ymnikaktys/cold-atmospheric-plasma-jet/README.md

# Autonomous Cold Atmospheric Plasma Jet (CAPJ)

High-voltage, nanosecond-pulsed dielectric barrier discharge (DBD) cold plasma torch with an autonomous 2S LiPo power supply, closed-loop resonant ZVS stage, and real-time microcontroller sequencing.

Designed for cold atmospheric plasma research in argon/nitrogen flows: delivers ultra-fast high-voltage streamer breakdown without thermal arc transition ($T_g \approx 300\text{--}315\text{ K}$, touch-safe plume).

---

## System Architecture

* **Primary Resonant Stage (ZVS Push-Pull):** Current-fed push-pull inverter (~98 kHz) using TI CSD18534Q5A NexFETs ($60\text{ V}$, $3.5\text{ m}\Omega$), Bourns SRP1265A $22\ \mu\text{H}$ feed choke, and CBB22 $0.22\ \mu\text{F}$ 630V resonant tank. Steps up $7.4\text{ V}$ battery power to $850\text{ V}$ via an EFD20 (N87/PC40) transformer.
* **Gate Drive & Zero-Crossing Sync:** Dual high-speed low-side driver TI UCC27524DR ($5\text{ A}$ peak). Real-time zero-crossing detection on MOSFET drains feeds directly into STM32 internal analog comparators (COMP1/COMP2) with BAT54C rail clamps to maintain soft-switching under varying loads.
* **HV DC Bus & Isolation:** $850\text{ V}$ buffer ($2\times \text{CBB81 } 1\text{ nF } 2000\text{V}$) with a $19.5\text{ M}\Omega$ thick-film bleeder array. Voltage feedback is fully isolated through a TI AMC1311 differential amplifier ($5\text{ kV}$ galvanic barrier) powered by a Mornsun B0505S-1WR3 ($3\text{ kV}$ DC-DC) and ME6211 LDO.
* **Nanosecond Pulsing Discharge:** Cree/Wolfspeed C3M0075120K SiC MOSFET ($1200\text{ V}$, $30\text{ A}$, TO-247-4) driven by a UCC27511DBVR at $+15\text{ V}$ (via MT3608 booster). True 4-pin Kelvin Source topology eliminates gate-loop ground bounce. Discharges the bus into an Epcos N87 ferrite toroid T2 (desoldering braid primary, UL3239 HV secondary) to hit $>7\text{ kV}_{p-p}$ at sub-15 ns rise times.
* **Clamping & Snubbing:** High-voltage SiC Schottky diode Cree C4D02120E ($1200\text{ V}$, zero reverse recovery) in an RCD clamp plus a primary RC snubber to eliminate destructive drain overshoots during nanosecond shut-off.
* **Fluidics & Gas Block:** Integrated 0520D 6V micro-solenoid for gas cut-off, tangential swirl chamber (swirl injection) with direct PC4-M5 pneumatic coupling, fused quartz tube ($\varnothing 6.0/\varnothing 4.0\text{ мм}$), and an axially centered WL-20 lanthanated tungsten needle.
* **Control Core:** WeAct Studio STM32G474CEU6 ($170\text{ MHz}$ Cortex-M4F, HRTIM with $184\text{ ps}$ resolution, ultra-fast comparators for sub-$25\text{ ns}$ OVP shutdown), 0.96″ SPI OLED, and EC11 digital encoder for gas profile/pulse repetition rate control.
* **Power & Protection:** 2S LiPo ($7.4\text{ V}$, $1100\text{ mAh}$, $140\text{C}$ burst), high-side soft-switch via AOD4185 P-MOSFET, AMFM 20A blade fuse in Keystone 3544 PCB clips, and synchronous MP2315 buck converter for clean $+3.3\text{ V}$ system rail.

---

## Physics & Simulation Targets

* **Output Voltage:** $V_{p-p} \approx 7.0\text{--}7.7\text{ kV}$
* **Slew Rate ($dV/dt$):** $>10\text{ kV/ns}$ (QSpice transient model yields up to $13\text{ kV/ns}$)
* **Pulse Duration:** $50\text{--}150\text{ ns}$
* **Discharge Mode:** Self-terminating Dielectric Barrier Discharge (DBD)
* **Gas Flow:** Industrial Argon / Nitrogen at $1.0\text{--}1.5\text{ bar}$ regulated line pressure

---

## Repository Layout

```text
├── docs/                 # System technical specifications, BOM sheets, and schematics PDF
├── firmware/             # STM32CubeIDE real-time C/C++ state machine (Preflow -> Charge -> Fire -> Postflow)
├── Hardware/             # Altium Designer 4-layer PCB design (CPJ.PcbDoc, hierarchical SchDocs, OutJob)
├── Libraries/            # Custom component libraries (symbols *.SchLib and footprints *.PcbLib)
├── mechanic/             # Enclosure CAD source and production assets
│   ├── 3d_print/         # Sliced/production STEP files (L/R shells, swirl nozzle block, trigger)
│   ├── components_step/  # Reference STEP models for grabcad/board components
│   └── Plasma_Pistol_Assembly.plasticity
├── outputs/              # Production Gerbers, NC drill, stackup info, and pick-and-place files
└── sim/                  # QSpice transient analysis circuits (*.qsch) and raw simulation captures

```
## Safety & Operating Notes

> [!CAUTION]
> ### DANGER: HIGH-VOLTAGE NANOSECOND PULSE GENERATOR
>
> * **Lethal Transients ($7.7\text{ kV}_{p-p}$):** Output pulse slew rate exceeds $10\text{ kV/ns}$. Never operate the board outside its grounded enclosure or without a differential HV probe ($100:1\ /\ 2\text{ kV}$ rating minimum).
>
> * **Stored Capacitive Energy ($850\text{ V}$):** The intermediate bus is buffered by polypropylene film capacitors. Wait at least **5 seconds** after cutting primary power for the bleeder resistor array ($19.5\text{ M}\Omega$) to safely drain the bus below $50\text{ V}$ before touching the board.
>
> * **Dielectric Protection:** Ensure continuous argon pre-flow prior to firing. Firing without gas flow will cause thermal air arc transition and permanent quartz tube erosion.
