ymnikaktys/cold-atmospheric-plasma-jet/docs/BOM.md

# Спецификация компонентов Cold Atmospheric Plasma Jet (Rev. 1.2)

> **Статус распределения:**
> * `[x]` — На руках куплено.
> * `(корзина VP)` — В корзине магазина.
> * `(корзина Алик)` — чипы, модули, силовые элементы и ленты с AliExpress
> * `(не закинуто)` — узлы второй очереди (моточная оснастка, сопло, пневматика, аккумулятор, корпус).

---

### Мозги (Управление и контроль) (УГО[x])

- [x] **Микроконтроллер:** WeAct Studio STM32G474CEU6
- [x] **Программатор:** WeAct Studio Mini STLink-STM32 v2.1
- [ ] **Защита ПК:** USB-изолятор на ADuM3160 — `(не закинуто)`
- [ ] **Высоковольтный щуп:** FNIRSI P4100 (100MHz, 100:1, 2 kV) — `(не закинуто)`
- [x] **Дисплей:** OLED 0.96″ 128×64, SSD1306, **SPI 7 pin**, белый
- [x] **Последовательные демпферы линий SPI:** Резисторы 33 Ом 1% SMD 0603 (40 шт.)
- [x] **ВЧ блокировочный конденсатор дисплея:** 100nF 50V X7R SMD 0603 (30 шт.)
- [x] **Локальный накопитель повышайки матрицы:** 10uF 16V X7R SMD 0805 (10 шт.)

---

### Ввод питания, защита и низковольтная логика (УГО[x])

1) Главный электронный рубильник питания (Q_PWR, SW_PWR):
    - [x] **Силовой P-Ch MOSFET рубильника (Q_PWR):** AOD4185 (TO-252)
    - [x] **Главный ползунковый микротумблер (SW_PWR):** SS-12D00G6 шток 6 мм
    *(Коммутирует только затвор мосфета на землю микротоком 0.08 мА).*
    - [x] **Подтяжка затвора ключа питания (100k):** Резистор 100k 1% SMD 0603 (40 шт.)

2) Защита от короткого замыкания (F1):
    - [x] **Предохранитель силовой шины (F1):** Ножевой AMFM-20A (2 шт.)

3) Входной сглаживающий фильтр (C3, C4 перед дросселем L6):
    - [x] **Держатели предохранителя на плату:** Клипсы Keystone 3544 под пайку (10 шт.)
    - [x] **Входной полимерный накопитель (перед L6):** 100uF 16V SMD 6.3×5.7 мм Hitano EZV
    *(Компенсирует паразитную индуктивность проводов батареи при импульсах).*
    - [x] **Входная ВЧ керамика фильтра:** 22uF 25V X7R SMD 1210 (10 шт.)
     *(3 х 22uf. Гасят реактивный ВЧ-ток 350 кГц с околонулевым ESR).*

4) Мониторинг напряжения аккумулятора (делитель на АЦП STM32):
    - [x] **Делитель мониторинга АКБ (верхнее плечо):** Резистор 100k 0603
    - [x] **Делитель мониторинга АКБ (нижнее плечо):** Резистор 47.5k 1% SMD 0603 (10 шт.)
    - [x] **Фильтр шумов АЦП батареи:** Конденсатор 100nF 0603
    *(Делит максимальные 8.4V батареи в безопасные 2.68V для прямого замера АЦП контроллера).*

5) Кнопка курка (BTN_TRIG):
    - [x] **Кнопка курка:** Тактовая кнопка BS-110-NL-Black

6) Инкрементальный энкодер навигации и выбора профилей газа (ENC1):
    - [x] **Инкрементальный энкодер (ENC1):** EC11 с кнопкой (вал с резьбой) `
    - [x] **Ручка энкодера:** Металлическая ручка под вал 6 мм

---

### Низковольтная часть (Силовой ZVS-контур):

1) Силовой ввод и аккумулятор:
    - [x] **Аккумулятор:** Акумулятор GNB 2S 720mAh 100C/200C HV XT30 8.7V
    - [x] **Силовой разъем на плату:** Amass XT30PW-M (угловой штыревой в плату)

2) Силовые ключи:
    - [x] **Силовые ключи ZVS (M1, M2):** CSD18534Q5A (DFN 5×6, 60V, 3.5 мОм, 5 шт.)

3) Готовый DC-DC преобразователь 3.3V (питание STM32, экрана и логики):
    - [x] **DC-DC логики +3.3V:** Синхронный понижающий модуль MP2315 (Mini-3A)

4) Драйвер и обвязка его:
    - [x] **Драйвер затворов ZVS:** Двухканальный UCC27524DR (SOIC-8, 5A)
    - [x] **ВЧ блокировка питания драйвера UCC27524:** 100nF 50V X7R 0603
    - [x] **Накопитель питания драйвера UCC27524:** 2.2uF 25V X7R SMD 0805 (10 шт.)
    *(Ставятся параллельно впритык к ножкам VDD (pin 6) и GND (pin 3) драйвера)*

5) Защита затворов (Снабберы и супрессоры):
    - [x] **Супрессоры защиты стоков (TVS 1-2):** 1.5SMC39A (SMC / DO-214AB, 20 шт.)
    - [x] **Снабберные резисторы стоков (R7, R8):** 5.62 Ом 1% SMD 1206 (25 шт.) —
    - [x] **Снабберные емкости стоков (C7, C8):** 2.2nF 100V NP0 SMD 1206 (20 шт.)

6) Входной накопительный дроссель пуш-пула (L6):
    - [x] **Входной дроссель питания ZVS:** Силовой SMD SRP-1265A 22uH (12×12×7 мм, 1 шт.)

7) Первичный резонансный конденсатор (C1):
    - [x] **Резонансный конденсатор первички (C1):** CBB22 0.22uF 630V P=15mm (10 шт.)

8) Трансформатор накачки шины 850V (T1):
    - [x] **Ферритовый сердечник T1:** EFD20 (каркас 8-pin + феррит N87 / PC40) —
    - [x] **Провод первички T1:** ПЭТВ-2 0.75 мм (1 м)
    - [x] **Провод вторички T1:** Тройная изоляция TIW-B 0.18–0.20 мм
    - [x] **Межобмоточная изоляция T1:** Каптоновый скотч 10 мм

---

### Детектор перехода через ноль (Zero-Crossing) и затворы ZVS (УГО[x])

1) Делители с дрейнов мосфетов (Drain Zero-Cross  на встроенные компараторы STM32):
    - [x] **Делители стоков ZVS (верхние плечи):** Резисторы 10k 0603
    - [x] **Делители стоков ZVS (нижние плечи):** Резисторы 1k 5% SMD 0603 (100 шт.)
    *(Делят выброс стока 35V до безопасных 3.18V прямо на пины COMP1_INP / COMP2_INP микроконтроллера)*
    - [x] **Защита входов компараторов STM32:** Диодная сборка BAT54C SOT-23 (30 шт.)
    *(Срезают любые импульсы выше 3.6V, гарантируя защиту пинов STM32)*

2) Обратные диоды быстрого закрытия (D14 и второй в паре):
    - [x] **Диоды быстрого разряда затворов:** Шоттки 1N5819HW SOD-123 (5 шт.)

3) Защитные стабилитроны затворов (D5, D6):
    - [x] **Защитные стабилитроны затворов:** BZX84-C15 SOT-23 (10 шт.)

3) Стягивающие резисторы затворов (R5, R6):
    - [x] **Стягивающие резисторы:** 10k 1% SMD 0603 (25 шт.)

4) Затворные резисторы включения (R3 и второй в паре):
    - [x] **Токоограничивающие резисторы затворов:** 4.7 Ом 0603 (40 шт.)

---

### Высоковольтный измеритель шины 850V (AMC1311) (УГО[x])
1) Изолированный усилитель напряжения:
    - [x] **Изолированный усилитель:** AMC1311BQDWVRQ1 (SOIC-8 Wide Body)

2) Высоковольтный делитель верхнего плеча (850V -> 1.7V):
    - [x] **Высоковольтный делитель верхнего плеча (850V):** Резисторы 510k 1% SMD 1210
    *4 штуки последовательно*
3) Нижнее плечо делителя и ВЧ фильтр:
    - [x] **Нижнее плечо делителя шины:** Резистор 3.9k 5% SMD 0603 (200 шт.)
    - [x] **ВЧ фильтр входа AMC1311:** Конденсатор 1nF 50V NP0 SMD 0603 (30 шт.)

4) Обвязка питания горячей стороны:

    - [x] **Гальваническая развязка питания 5V (3 кВ):** Mornsun B0505S-1WR3 (SIP-4)
    - [x] **LDO горячей стороны AMC1311:** ME6211C50M5G (5.0V, SOT-23-5, 5 шт.)
    *(Сбрасывает 7.4V с батареи до чистых 5.0V без просадок при старте)*
    - [x] **Входная емкость LDO ME6211:** Конденсатор 4.7uF 16V X7R SMD 0805 (10 шт.)
    *Фильтрующая керамика на вход ME6211*
    - [x] **Догрузочный резистор B0505S:** Резистор 300 Ом 1% SMD 0805 (100 шт.)
    *(Дает стабильный ток 15 мА, удерживая выход B0505S ровно на 5.0V без бросков до 7V)*
    - [x] **Локальный блокировочный конденсатор AMC1311:** 100nF 50V X7R 0603
    *(Ставится в упор к выводам VDD1 и GND1 микросхемы AMC1311)*

---

### Высоковольтный наносекундный разрядник сопла (850V -> 7.7 kVpp) (УГО[x])
1) Выпрямитель вторички транса T1:
    - [x] **Мостовой выпрямитель T1:** Ультрабыстрые диоды US2M (1000V, 2A, 75ns, SMA)
    *2 шт. последовательно на каждое плечо*

2) Буферный HV накопитель (C_BUF) — запас 2000V:
    - [x] **Буферный накопитель шины (C_BUF):** Полипропилен CBB81 1nF 2000V P=15mm
    *(2 шт по 1nf в паралель ибо закончились 2.2nf, если найду на алике то они)*

3) Безопасный разряд шины (Bleeder):
    - [x] **Цепь безопасного разряда (Bleeder):** Резисторы 3.9 МОм 1206 (100 шт.)
    *как я понял мне надо последовательно наебенить чтоб +- 20МОм было*

4) Силовой наносекундный ключ (SiC MOSFET):
    - [x] **Силовой SiC-ключ разряда:** Cree / Wolfspeed C3M0075120K (1200V, 75 мОм, TO-247-4)
    *(Именно 4-выводной корпус с кельвиновским истоком! Он устраняет паразитную индуктивность истока и позволяет открываться за 4 наносекунды без звона)*

5) Драйвер SiC-затвора и обвязка:
    - [x] **Сверхбыстрый драйвер затвора SiC:** UCC27511DBVR (SOT-23-6, 10 шт.)
    - [x] **Затворный резистор включения SiC (OUTH):** 4.7 Ом 0603
    - [x] **Затворная цепь выключения SiC (OUTL):** 22 Ом 1206 (100 шт.)
     *ставится только футпринт резистора 0603/0805/1206 на всякий случай а так просто перемычка каплей припоя*
    - [x] **Стягивающий резистор затвора SiC:** 10k SMD 0603
    - [x] **Защитный Rail-to-Rail клампер затвора SiC:** Диодная сборка Шоттки BAT54S (SOT-23, 5 шт.)
    *(Сдвоенный диод со средней точкой на затвор. Сбрасывает наносекундные выбросы емкости Миллера в шину питания драйвера +15V и в Kelvin GND, исключая пробой подзатворного диэлектрика)*

6) Питание затвора SiC (+15V):
    - [x] **Питание драйвера SiC (+15V):** Регулируемый Step-Up модуль MT3608
    *(Размер всего 17х36 мм, питается от 7.4V батареи, выдает стабильные 15V на UCC27511)*
    - [x] **Локальный накопитель шины +15V:** 10uF 16V 0805

7) Импульсный автотрансформатор сопла (T2):
    - [x] **Сердечник автотрансформатора T2:** Ферритовое кольцо Epcos B64290-L632-X87 (N87)
    - [x] **Первичная обмотка T2:** Медная оплетка для выпайки 3.0 мм
    - [x] **Вторичная обмотка T2:** Провод UL3239 28AWG (7*0.12)

---

### Демпфирование и снабберы SiC-ступени (УГО[x])

1) Диод высоковольтного клампера (D8 / D_SIC_HV):
    - [x] **Диод высоковольтного клампера (D_SIC_HV):** Диод C4D02120E /CREE /TO-252

(я в душе не ебу что это)
- [x] **Запасной банк подстройки резонанса:** Конденсатор CBB81 470pF 2000V (5 шт.)
(я в душе не ебу что это)

2) RCD Клампер:
    - [x] **Емкость клампера (C_cl):** Полипропилен CBB81 3.3nF 2000V P=15mm (5 шт.)
    - [x] **Резистор сброса клампера (R20):** 4.7 кОм 1% SMD 1206 (100 шт.)
    *2 последовательно + 2 паралельно, тепловыделение 0.25 Вт:*

3) Элементы RC-снаббера первичной обмотки (R2, Csn):
    - [x] **Конденсатор снаббера первички T2 (C_sn):** CBB81 470 + 330 pF 2000V
    - [x] **Резистор снаббера первички T2 (R2):** 12 Ом 5% 1W SMD 2512 (20 шт.)
    *последовательно 3 шт максимальная разница потенциалов на них в импульсе 600 вольт Average value of P(R2) is 1.33993 over the range of 0 to 0.005 (ГЫГЫГЫ ещё и 2 паралельно)*

---

### Электропневматика и газовая магистраль (УГО[x])

1) Электромагнитный микроклапан подачи газа (SOL1):
    - [x] **Микросоленоид отсечки газа (SOL1):** 0520D нормально закрытый (DC 3–6V) —
    *(Управляет отсечкой газа. Открывается контроллером на предпродувку до пробоя и удерживается во время генерации)*

2) Драйвер соленоида на плате (Q_SOL, D_FLY, R_GATE):
    - [x] **Ключ управления соленоидом (Q_SOL):** AO3400A (N-Ch 30V 5.7A, SOT-23)
    *(Управляется напрямую логическим уровнем 3.3V с пина STM32 без промежуточных драйверов)*
    - [x] **Диод гашения ЭДС самоиндукции (D_FLY):** 1N5819HW
    *(Ставится параллельно выводам катушки катодом к плюсу питания, чтобы обратный выброс ЭДС не выбил AO3400A)*
    - [x] **Затворный резистор ключа клапана:** Резистор 110 Ом 0.1% SMD 0805 (20 шт.)
    - [x] **Стягивающий резистор затвора соленоида:** Резистор 10k 0603

3) Пневматическая трасса и штуцеры:
    - [x] **Пневмотрубка магистрали:** Полиуретан PU 4×2.5 мм
    - [x] **Штуцер коллектора сопла:** Цанговый фитинг PC4-M5 под трубку 4 мм — `(корзина Алик)`
    *(Вкручивается в напечатанный газовый блок ствола)*

4) Редукционный узел высокого давления и автономное питание (будет на rev 2):
    - [ ] **Портативный микроредуктор газа:** Регулятор с манометром 3/8"-24 UNF (0–2 бар)
    *(Сбрасывает входные 100–150 бар баллона до стабильных 1.0–1.5 бар на вход соленоида)*
    - [ ] **Баллончики газа:** Нержавеющие 16g с резьбой 3/8"-24 UNF и встроенным ниппелем
    *(Встроенный подпружиненный клапан позволяет выкручивать баллончик из рукоятки в любой момент без стравливания оставшегося газа)*
---

### Механика сопла, разрядная камера и электроды (УГО[x])
1) Диэлектрический разрядный канал:
    - [x] **Кварцевый канал:** Трубка Fused Quartz OD 6.0 мм, ID 4.0 мм, длина 100 мм

2) Центральный высоковольтный электрод:
    - [ ] **Центральный электрод:** Вольфрамовый пруток WL-20 (с оксидом лантана, синий торец) 1.0–1.6 мм — `(не закинуто)`

3) Герметизация и демпфирование кварца:
    - [x] **Уплотнители камеры сопла:** Силиконовые кольца O-ring 6×1.5 мм `
    *(Укладываются в посадочные канавки газового блока. Исключают прямой контакт хрупкого кварца с жестким пластиком корпуса)*

4) Внешний электрод барьера (GND):
    - [x] **Внешний барьерный электрод (GND):** Медный самоклеящийся скотч 8–10 мм
    *(Наклеивается кольцом снаружи кварцевой трубки на удалении 10–15 мм от острия иглы и подпаивается проводом к полигону GND)*

5) Ламинаризатор газового потока (заменен тангенсальной вихревой камерой но есть x):
   - Спеченный пористый бронзовый фильтр-глушитель: пневмоглушитель резьба М5 или 1/8" – 22₴
   *(Пористая бронзовая таблетка выпрессовывается из корпуса глушителя и монтируется на вход кварцевой трубки для гашения завихрений)*
---

### Сборочный крепеж корпуса (PETG 3D-печать)

1) Металлические резьбовые колодцы под пайку в пластик:
    - [x] **Резьбовые колодцы:** Вплавляемые латунные втулки М3×4 мм (20 шт.)
    *(Вплавляются жалом паяльника на 230°C в стойки напечатанного корпуса из PETG. Дают многоразовую жесткую резьбу)*

2) Силовые винты сборки створок корпуса:
    - [x] **Винты стяжки створок:** Винты с цилиндрической головкой DIN 912 М3×10/12 мм (20 шт.) `
