ymnikaktys/cold-atmospheric-plasma-jet/mechanic/3d_print/NOZZLE.step

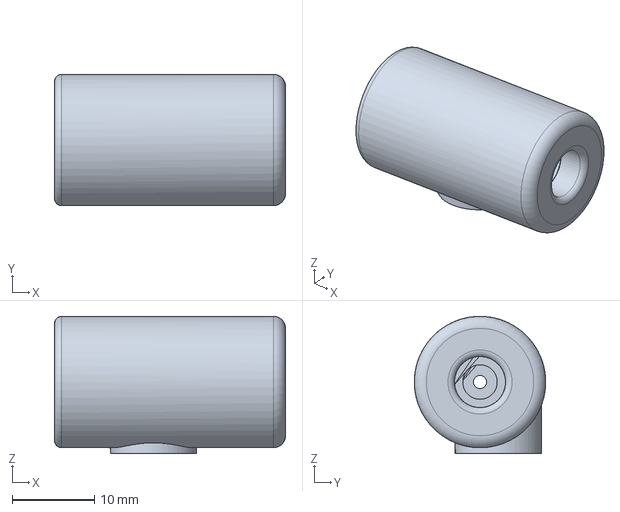
[picture p1: CAD file, 2026-11-13]
mechanic/3d_print/NOZZLE.step
28.1 x 16.0 x 16.7 mm
