ymnikaktys/cold-atmospheric-plasma-jet/mechanic/components_step/Pneumatic Quick Connector Poc 4 M5.step

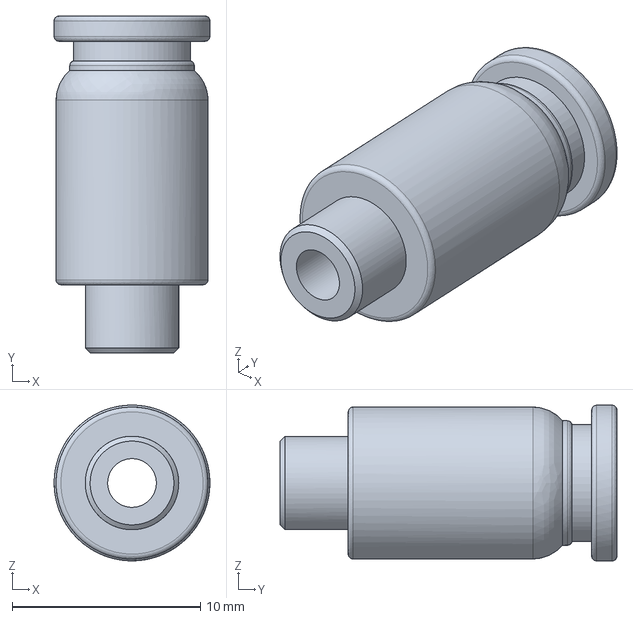
[picture p2: CAD file, 2026-10-26]
mechanic/components_step/Pneumatic Quick Connector Poc 4 M5.step
8.29 x 17.9 x 8.29 mm
