ymnikaktys/cold-atmospheric-plasma-jet/mechanic/3d_print/CASE_R.step

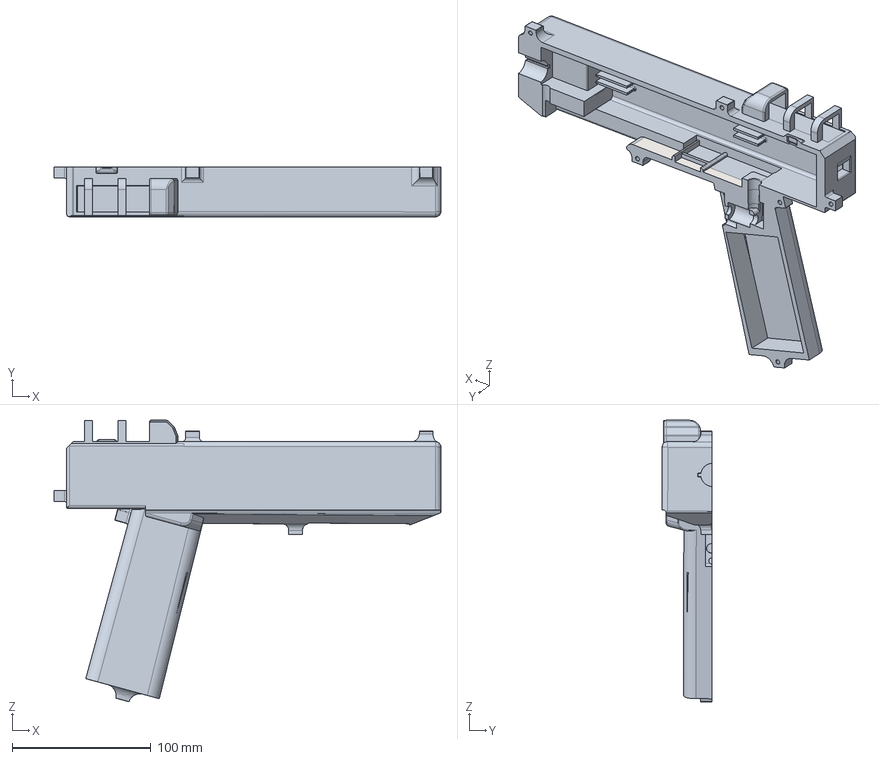
[picture p3: CAD file, 2026-11-13]
mechanic/3d_print/CASE_R.step
278.9 x 35.8 x 203.0 mm
