ymnikaktys/cold-atmospheric-plasma-jet/mechanic/components_step/PCB.step

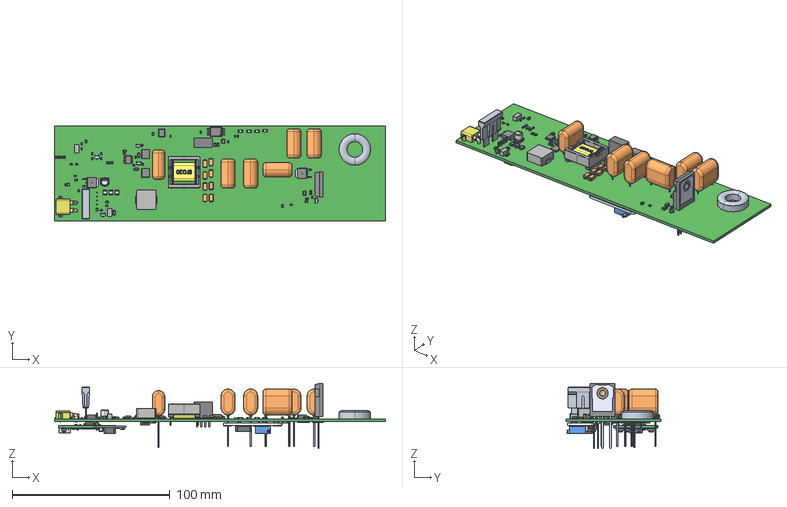
[picture p4: CAD file, 2026-10-26]
mechanic/components_step/PCB.step
210.0 x 60.0 x 41.5 mm
05KJ_Mini_PCB_Regulator
1_Male_Pin_2.54_mm x 4
Body001 (Mirror #1) x 8
XY-plane x 24
X-axis x 24
UCC27511DBVR--3DModel-STEP-56544
VJ0603D110KXCAP x 36
Body_2.0x1.25x1.25x0.5 x 11
Contact_1.25x1.25x0.5 x 22
XT30PW-M--3DModel-STEP-269445
AMC1311BDWVR
SIP4_B_S-1WR3_MNS
ME6211C33M5G--3DModel-STEP-269445
Leader x 8
Mid_Body x 5
Mark x 5
R0603 x 10
Extruded x 5
Mid_Body (2) x 2
Mark (1) x 2
Extruded (1) x 7
USB_Type-C_A
Board_1 x 3
Extruded_9 x 3
Extruded_10 x 3
Extruded_11 x 3
Extruded_12 x 3
Extruded_13 x 3
Extruded_14 x 3
Extruded_15 x 3
Extruded_16 x 6
Extruded_17 x 6
NX3215SA
Extruded (2)
User Library-SOD323
P2
Mid_Body (8) x 2
Mark (2) x 2
Mid_Body (9)
Mark (3)
User Library-SG310
User Library-SOT23-3
CircuitWorks-SOT-23 x 2
CircuitWorks-SOT-23 (1)
Mid_Body (10)
Mark (4)
P1
User Library-led_0603LED0603 red x 2
c61020-a0020-c014-r20-10-7
c61036-a0156-b201_efd20_sw_Standard
c61036-a0156-c001-efd20_Standard x 2
RHC2512FT33R0 x 6
Body_3.2x1.6x0.8x0.6 x 17
Contact_1.6x0.8x0.6 x 34
MMBT3904--3DModel-STEP-711646 x 5
C3M0075120K1--3DModel-STEP-740395
CSD18534Q5A x 2
AOD4185 x 2
SRP1265A-470M--3DModel-STEP-510211
1N5819HW-7-F--3DModel-STEP-56544 x 3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
