ymnikaktys/cold-atmospheric-plasma-jet/mechanic/3d_print/CASE_L.step

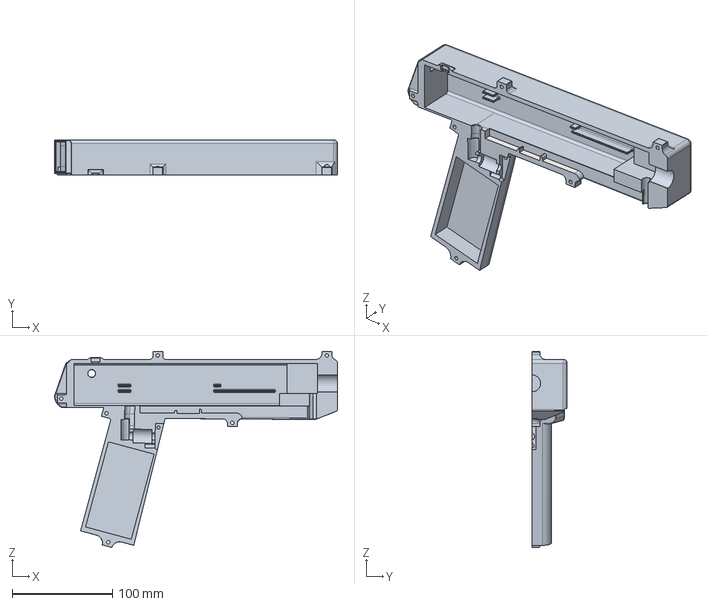
[picture p5: CAD file, 2026-11-13]
mechanic/3d_print/CASE_L.step
282.0 x 35.2 x 195.3 mm
