ymnikaktys/cold-atmospheric-plasma-jet/mechanic/components_step/4V-6V Linear Solenoid.STEP

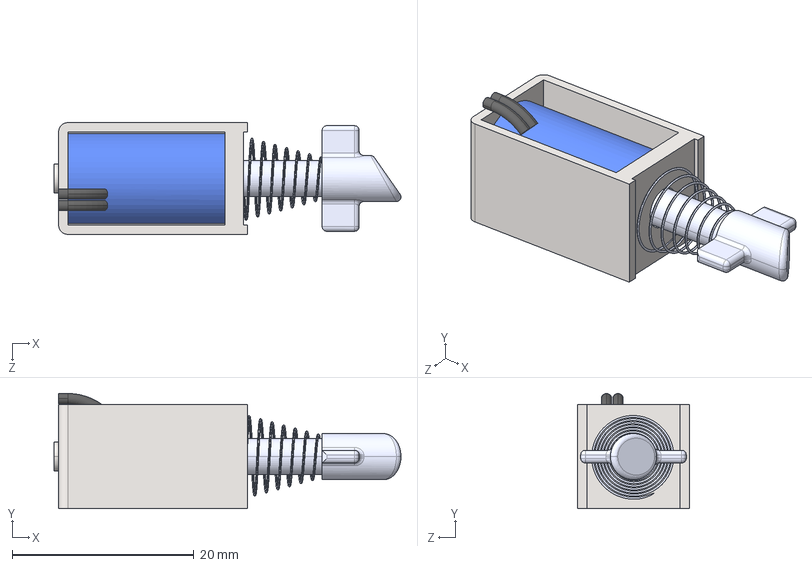
[picture p6: CAD file, 2026-10-26]
mechanic/components_step/4V-6V Linear Solenoid.STEP
38.2 x 12.7 x 12.3 mm
Solenoid A Body
Solenoid A Shaft PLastic Tip Wide
