ymnikaktys/cold-atmospheric-plasma-jet/mechanic/3d_print/TRIG.step

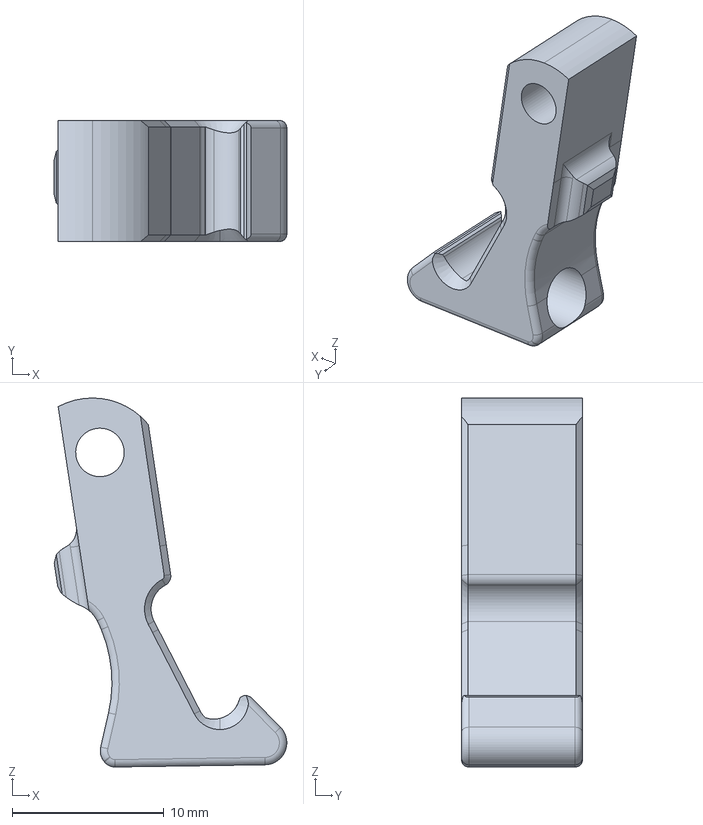
[picture p7: CAD file, 2026-10-26]
mechanic/3d_print/TRIG.step
15.4 x 8.00 x 24.4 mm
