ymnikaktys/cold-atmospheric-plasma-jet/mechanic/components_step/Push button Switch Press reset switch PBS-110.stp

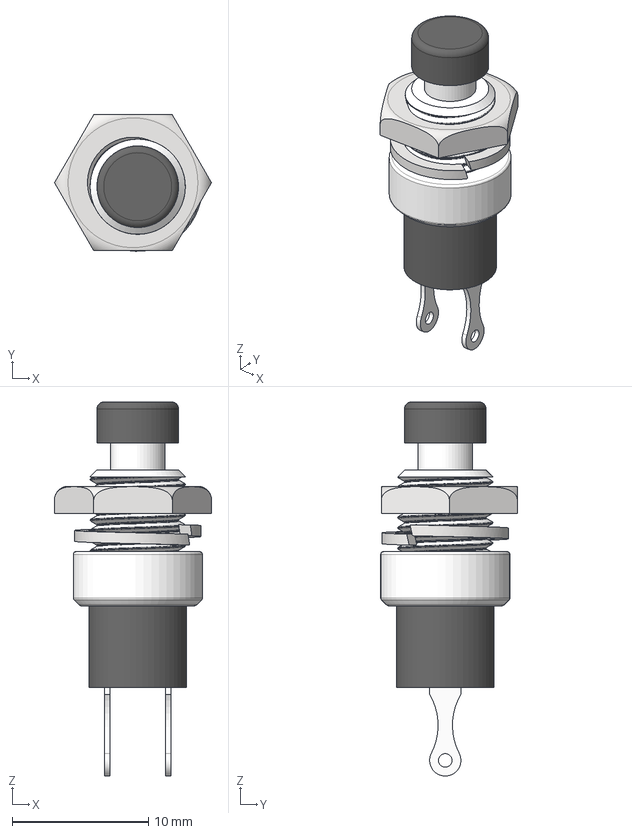
[picture p8: CAD file, 2026-10-26]
mechanic/components_step/Push button Switch Press reset switch PBS-110.stp
11.5 x 10.0 x 27.5 mm
Self reset PBS-110 7mm Momentary Push button Switch
Nut_M7x0.75
Spring
