ymnikaktys/cold-atmospheric-plasma-jet/mechanic/components_step/ec11e18244a5.stp

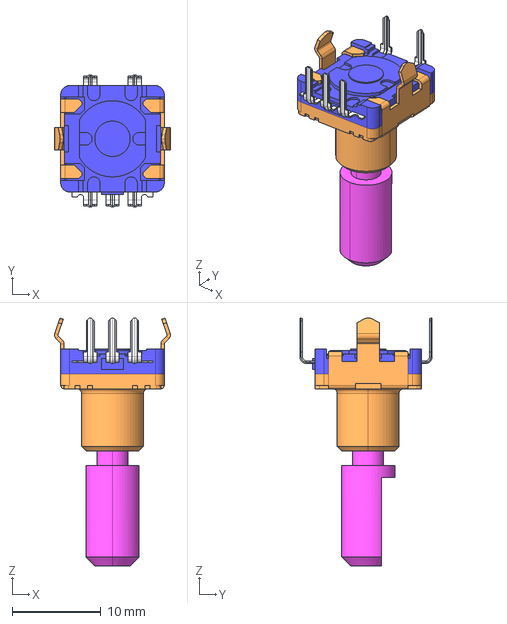
[picture p9: CAD file, 2026-10-26]
mechanic/components_step/ec11e18244a5.stp
13.1 x 15.0 x 28.0 mm
