ymnikaktys/cold-atmospheric-plasma-jet/(list of files, cad)

Other CAD files:
mechanic/NOZZLE.stl
