ymnikaktys/cold-atmospheric-plasma-jet/docs/DBD_plasma.pdf

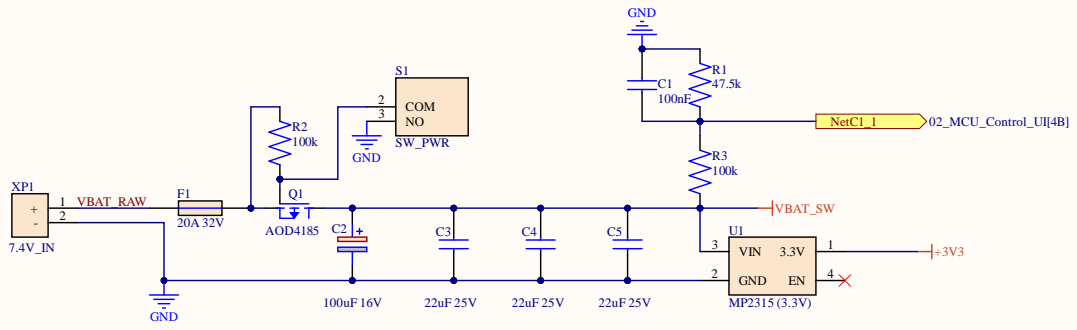
[picture p10: page 1]

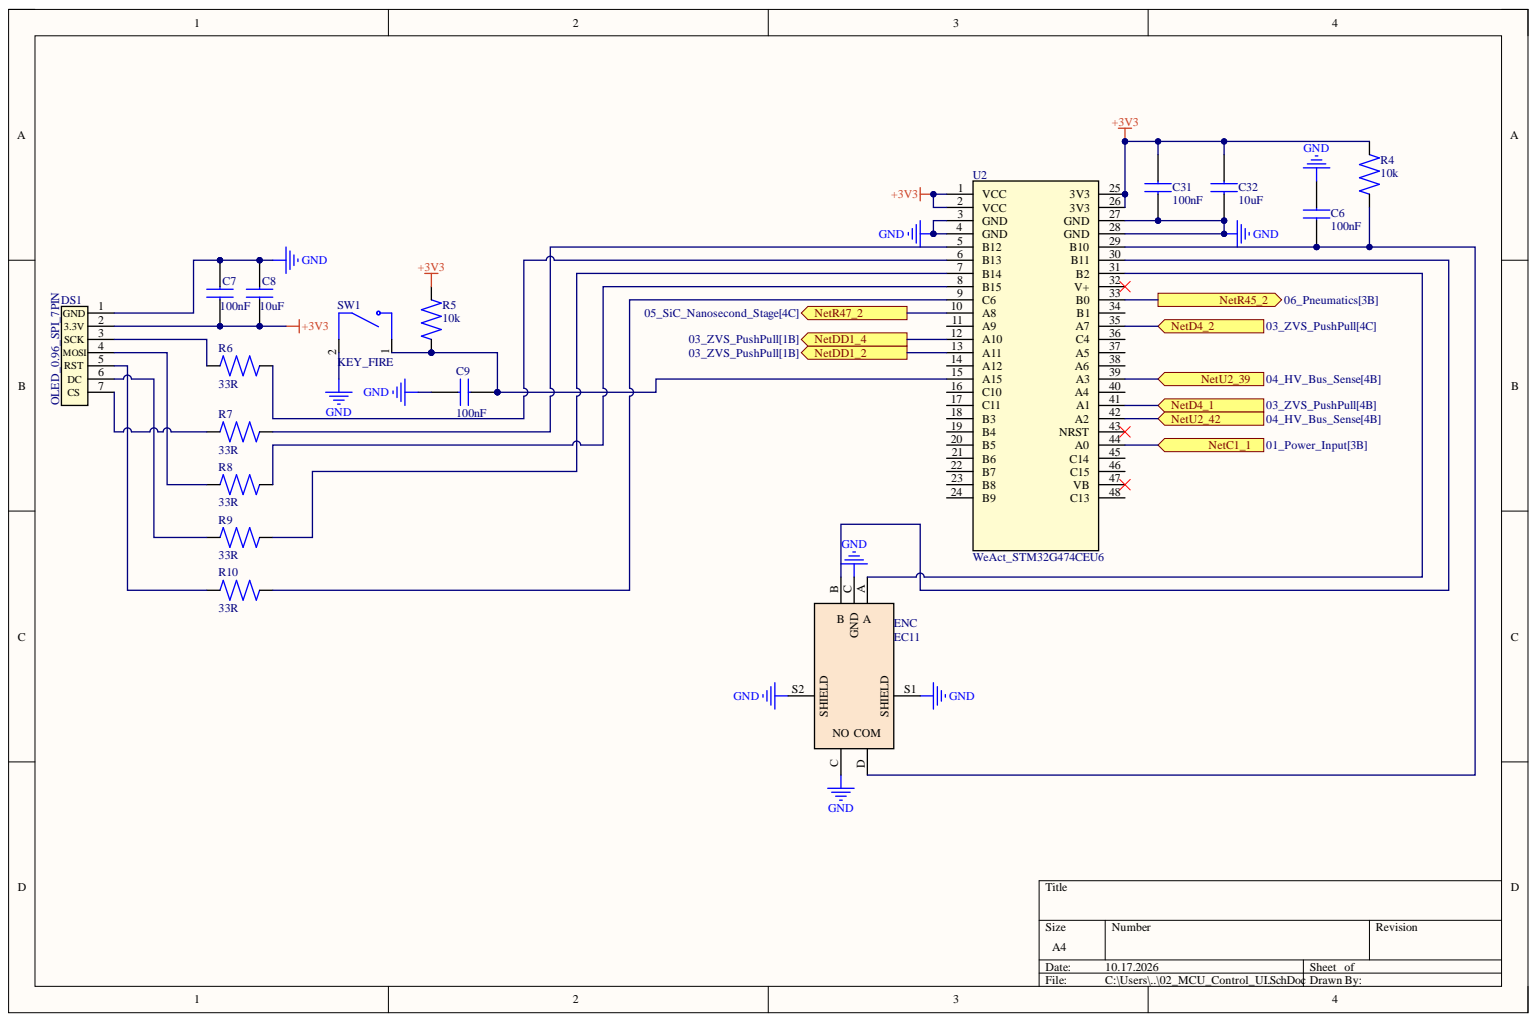
[picture p11: page 2]

8 | 2 WeAct B1 5 V + C6 B0 A 8 B1 A 9 A 7 A 1 0 C4 A 1 1 A 5 A 1 2 A 6 A 1 5 A 3 C1 0 A 4 C1 1 A 1 B3 A 2 B4 NRS T B5 A 0 B6 C1 4 B7 C1 5 B8 V B B9 C1 3 | 3 2

4 | | 2 8
5 | | 2 9
6 | | 3 0
7 | | 3 1

0 5 _SiC_ Nan o seco n d _St ag e [ 4 C ] NetR4 7 _ 2 0 3 _ Z VS_Pu s hPu l l [ 1 B ] Net D D 1 _4 0 3 _ Z VS_Pu s hPu l l [ 1 B ] Net D D 1 _ 2 | | 1 0 | | 3 4

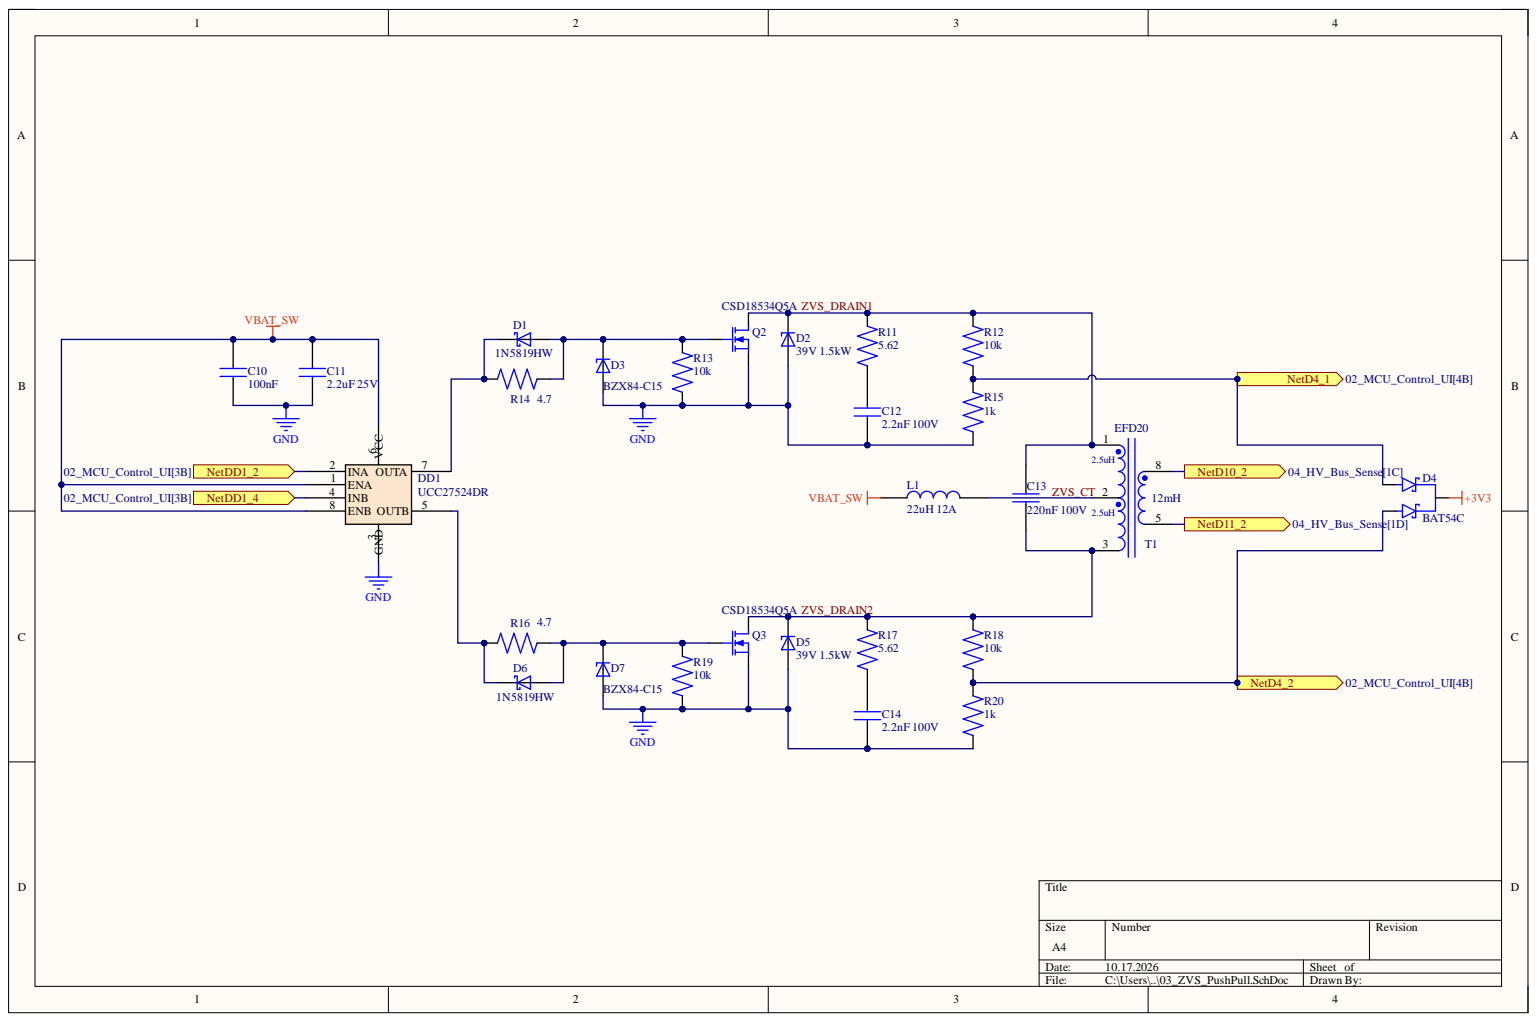
[picture p12: page 3]

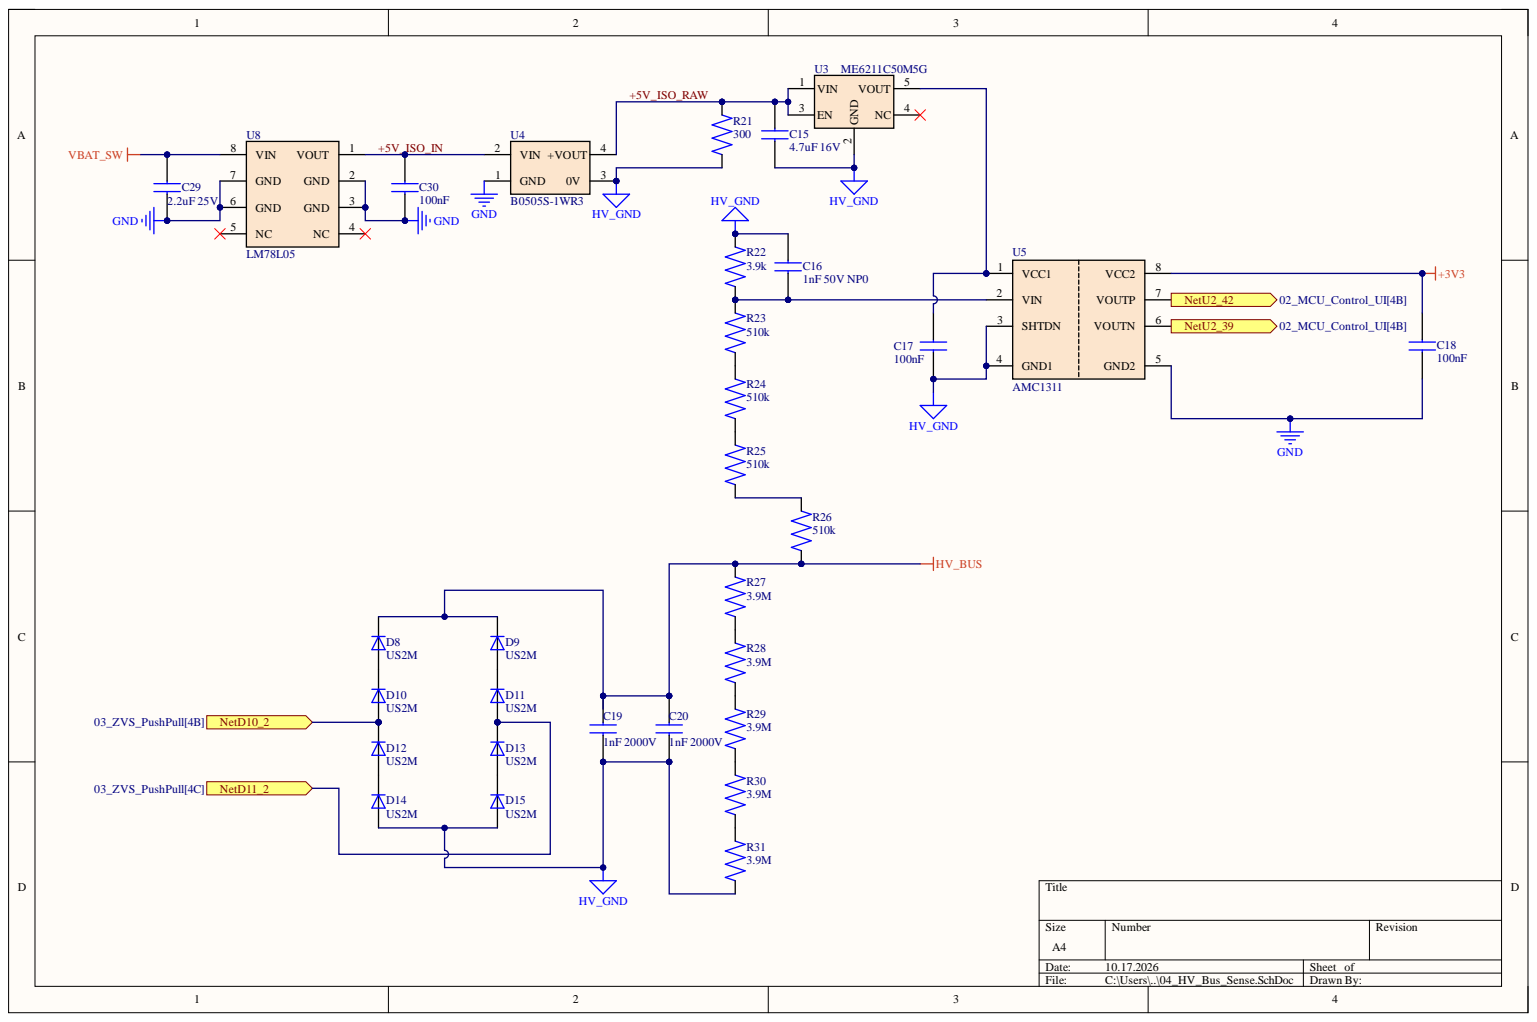
[picture p13: page 4]

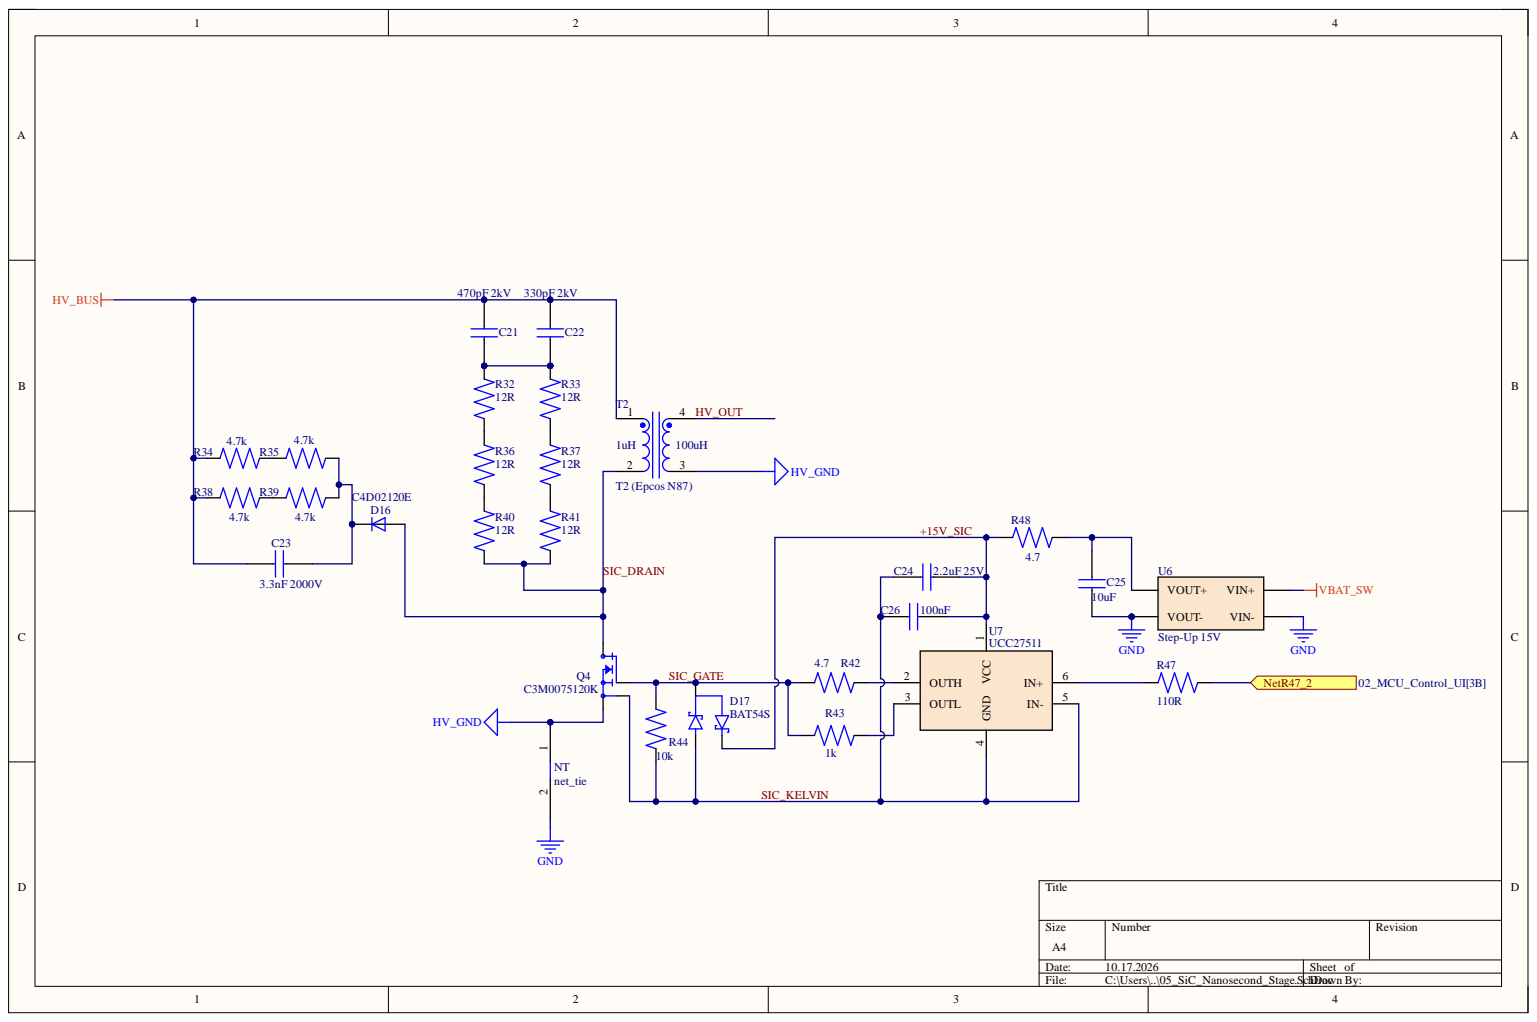
[picture p14: page 5]

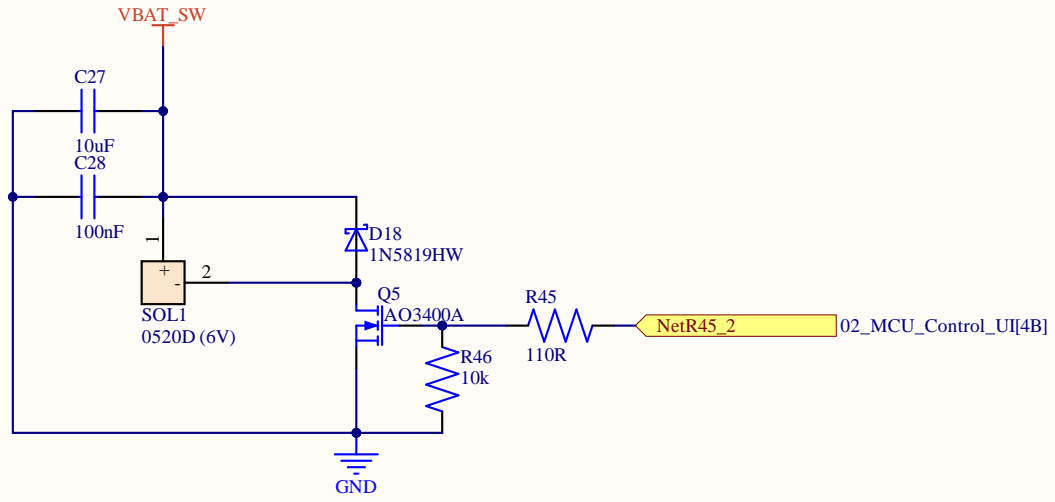
[picture p15: page 6]

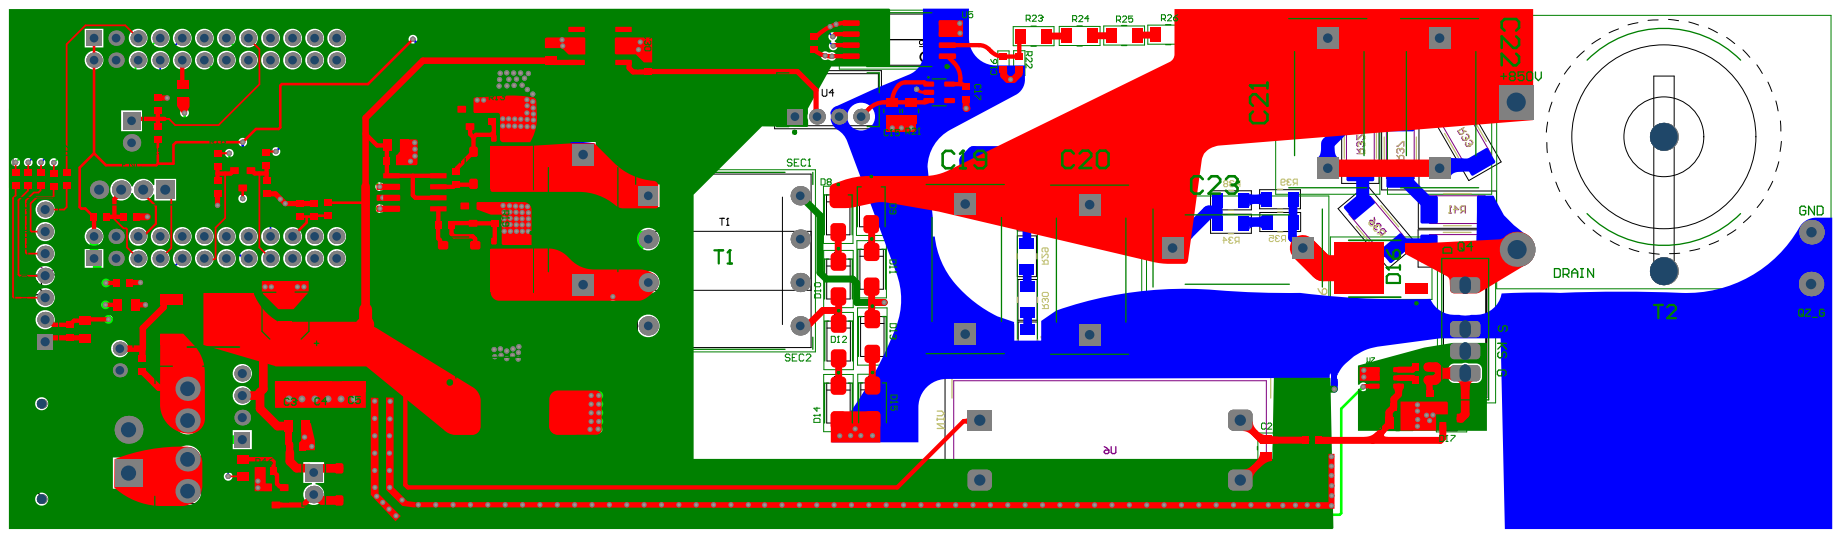
[picture p16: page 7]
