ymnikaktys/cold-atmospheric-plasma-jet/(list of files, drawings)

Other design files:
Hardware/01_Power_Input.SchDoc
Hardware/02_MCU_Control_UI.SchDoc
Hardware/03_ZVS_PushPull.SchDoc
Hardware/04_HV_Bus_Sense.SchDoc
Hardware/05_SiC_Nanosecond_Stage.SchDoc
Hardware/06_Pneumatics.SchDoc
Hardware/CPJ.PcbDoc
Hardware/DBD_plasma.PrjPcb
