ymnikaktys/cold-atmospheric-plasma-jet/(commit log)

2026-09-29 feat(hw): add initial schematic library, footprint mappings, and BOM list
2026-09-29 feat(hw): add custom schematic and pcb libraries, init folder tree
    [DBD_plasma.PrjPcb, Sheet1.SchDoc]
2026-10-07 feat(lib): complete hardware footprint library and sync SchLib/BOM - Add verified PcbLib footprints: Epcos R20 toroid, CoreTech EFD20 THT bobbin, Keystone 3544 fuse clips, WeAct STM32G474 module, SON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
    [DBD_plasma.PrjPcb]
2026-10-09 Add schematics for main stages and update SchLib components
    - Added 5 principal Altium schematic sheets:
    - 01_Power_Input
    - 02_MCU_Control_UI
    - 03_ZVS_PushPull
    - 04_HV_Bus_Sense
    - 05_SiC_Nanosecond_Stage
    - Implemented and wired global ports across all sheets
    - Integrated net ties for isolation boundaries
    - Updated and refined schematic symbol library (SchLib)
    [01_Power_Input.SchDoc, 02_MCU_Control_UI.SchDoc, 03_ZVS_PushPull.SchDoc, 04_HV_Bus_Sense.SchDoc, 05_SiC_Nanosecond_Stage.SchDoc, 06_Pneumatics.SchDoc, DBD_plasma.PrjPcb, Sheet1.SchDoc]
2026-10-09 feat(hw): add design rules, net classes, and LDO; update footprints and symbols
    - Add DRC design rules and clearance constraints
    - Add LDO voltage regulator stage
    - Configure dedicated net classes for routing
    - Update selected PCB footprints and schematic symbols
    [01_Power_Input.SchDoc, 02_MCU_Control_UI.SchDoc, 03_ZVS_PushPull.SchDoc, 04_HV_Bus_Sense.SchDoc, 05_SiC_Nanosecond_Stage.SchDoc, 06_Pneumatics.SchDoc, DBD_plasma.PrjPcb]
2026-10-11 refactor(pcb): update sheets 1-2 schematics and complete ZVS stage placement
    - Schematics: finalize Sheet 1 & 2 (power input, MCU UI filters, SPI damping, local decoupling)
    - Libraries: update SchLib/PcbLib footprints and adjust WeAct 3D STEP models
    - Placement: complete dense layout for sheets 1-2 (UI, MP2315 buck converter, input filters)
    - ZVS stage: symmetrical push-pull layout with centered UCC27524 driver and CSD18534Q5A FETs
    - Power & Isolation: route ZVS_CT rail on L3 with via stitching; maintain Top-only HV isolation barrier
    [01_Power_Input.SchDoc, 02_MCU_Control_UI.SchDoc, 03_ZVS_PushPull.SchDoc]
2026-10-12 pcb: complete component placement and configure high-voltage DRC rules
    - Finalized floorplanning for ~150 components across all functional stages
    - Clustered nanosecond SiC switching loop (Q4, T2, snubber, RCD clamp) to minimize parasitic loop inductance
    - Removed redundant J1 HV terminal in favor of direct T2 pin routing
    - Positioned U6 (+15V step-up) at south rail away from high dv/dt switching node
    - Finalized solenoid driver layout (Q5, flyback D18, local decoupling)
    - Configured multi-tier DRC clearance rules (850V DC, 8mm HV pulse, component boundary 2D clearance)
    - Prepared design for trace routing and netlist cleanup
2026-10-14 feat(layout): complete HV power stage routing and AMC1311 isolation
    - Route full-bridge HV rectifier (D8-D15) with L2 secondary crossover
    - Finalize SiC MOSFET Q4 power loop, snubbers, and Kelvin source return
    - Implement Board Cutout isolation slot and LDO power circuitry for AMC1311
    - Add NPTH tie-wrap mounting slots for T2 toroidal core
2026-10-15 feat(pcb): route input power stage, 3V3 rail, solenoid, and ZVS primary loops
    - Route raw battery input (XP1), fuse clip (F1), and main power switch (Q1)
    - Lay out input filter network with bulk electrolytic C2 and C3-C5 HF ceramic bypass caps
    - Pour high-current VBAT_SW polygon feeding the resonant choke L1
    - Route +3V3 logic rail on bottom layer clear of high-current THT pads
    - Implement solenoid driver stage (Q5, flyback diode D18, and gate pulldown)
    - Route primary push-pull ZVS stage:
    * Symmetrical low-inductance drain polygons (ZVS_DRAIN1 / ZVS_DRAIN2)
    * Direct coupling to C13 resonant tank and T1 primary pads
    * Integrate RC snubbers and TVS clamps with low-ESL multi-via groun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
2026-10-16 feat(hw): finalize ZVS power stage layout and route shielded SiC gate drive line
    - Complete symmetrical copper pours and thermal via stitching for CSD18534 ZVS stage
    - Route 150mm nanosecond SIC_DRV trace on Layer 3 with source termination (R47)
    - Implement coplanar GND via shielding along southern board edge with 2mm pitch
    - Enforce creepage/clearance rules and isolation boundary for AMC1311 and floating HV_GND
    - ~95% routed, 10 miscellaneous UI/logic nets remaining before final DRC
2026-10-18 feat(pcb): complete 4-layer routing, achieve DRC 0/0, and export JLCPCB fabrication package
    - Route remaining low-voltage digital control lines, STM32 HRTIM PWM drives, and analog feedback loops
    - Complete bottom-layer layout for high-power passive networks:
    * 5-stage HV feedback voltage divider (R27-R31) with clearance isolation
    * High-dissipation snubber/damping resistors (R32-R41) with optimized thermal polygons
    - Verify physical clearances and design constraints: passed DRC with 0 errors / 0 warnings
    - Convert board shape and internal isolation cutouts to 0.1mm primitives on Mechanical 1 (CPJ.GM1)
    * Add creepage milling slots beneath AMC1311 isolation amplifier and optocouplers
    - G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
2026-10-21 Gerber outputs, sch.doc PDF scheme
2026-10-26 feat(mech): finalize split enclosure, swirl nozzle block, and export print STEPs
    - Model 2-piece split body with 6x M3 external mounting ears
    - Integrate tangential swirl gas chamber with direct PC4-M5 fitting interface
    - Export 4 standalone STEP AP214 solids for FDM printing (shells, nozzle, trigger)
    - Clean up mechanic folder structure and update project README
2026-10-26 fix(mech): add external counterbores and M3 clearance holes to left shell
2026-11-13 feat(fw): Step 0 bare-metal bring-up for STM32G474
    - Add CMSIS headers and linker scripts for STM32G474CEU6
    - Implement 170 MHz PLL boost mode clock init and lock-free SysTick
    - Clamp gate driver pins (PA8, PA10, PA11, PB0) to GND on boot and lock unused GPIOs to Analog
